mintynet/BSidesScotland2019/README.md

# BSidesScotland2019
Repository for information on the BSides Scotland 2019 / Car Hacking Village UK Badge
<br>The badge is a cheap device for people to get into car hacking, the sketch that will be below will cause disco mode on PD0 'The Car in a Box'
<br><br><b>BSides Scotland and I take no responsibility for any issues caused if using either the hardware or the code</b>
<br><br>Requires the use of the following Arduino library
<br><br>https://github.com/coryjfowler/MCP_CAN_lib
<br><br>Below is the components which are required to build your own BSides Scotland 2019 Badge
<br><br>The components shown below are available from aliexpress/ebay/amazon in that order of cost, but delivery time is probably highest on the cheaper.
<br><b>[Arduino Nano]</b>(https://www.ebay.co.uk/itm/USB-Nano-V3-0-ATMEGA328P-CH340G-5V-16M-Micro-Controller-Board-For-Arduino/201649419996)
<br><b>[MCP2515 Module]</b>(https://www.ebay.co.uk/itm/For-Arduino-MCP2515-CAN-Bus-Module-TJA1050-Receiver-SPI-Module/311520457612)
<br>I have used the above links from alice1101983 myself and delivery is normally 3 weeks to UK
<br><b>[OBD2 Plug]</b>(https://www.aliexpress.com/item/Car-Diagnostic-Tool-OBD-Male-Plug-16Pin-OBD2-Connector-OBD-2-16-Pin-OBD-II-Adaptor/32790225414.html)
<br>I have also used the above link, delivery has been varied from 9 to 40 days, but that may because I was ordering bulk.

<br><br>https://github.com/mintynet/nano-can has the other sketches for the device.

<br><b>Schematic</b>
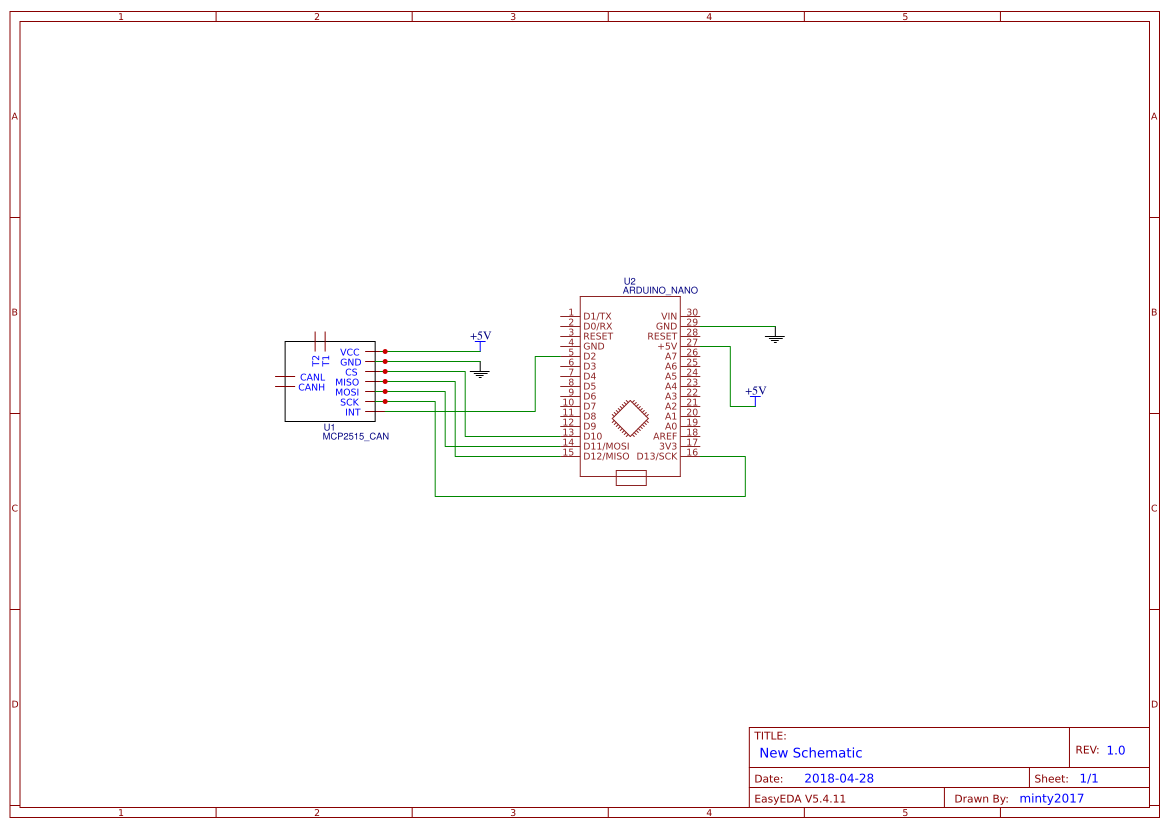
[picture p1: Schematic_nano-can-pcb.png]
PCB Schematic

Note:
<br><b>Arduino Nano</b>, the square at one end denote the position of the USB connector.
<br><b>TIP</b><br>Add extra solder to the sides of the USB connector or you may rip the USB connector of the board
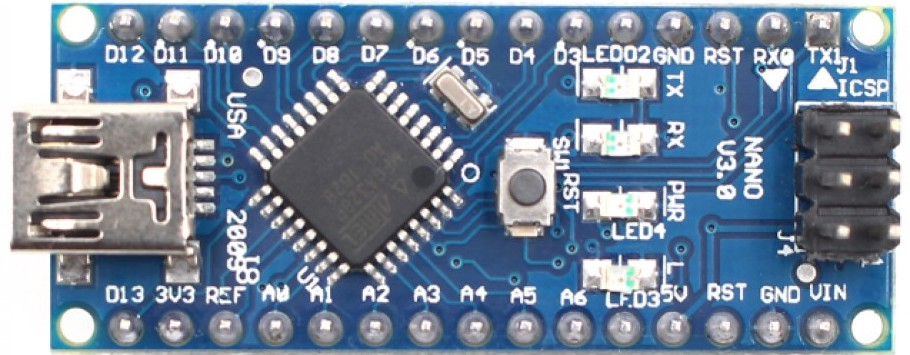
[picture p2: arduino-nano.jpg]
Arduino Nano

<br><b>MCP2515 Module</b> goes below the nano but <b>DO NOT</b> solder the Terminator Jumper or CAN pin headers to the PCB
<br>You may require a jumper on the Terminator resistor if using back to back.
<br>To solder the CAN module to the board, add extra solder to the back of the pins, then heat the pins and push through so that the pins are on the rear, then remove the plastic pin spacer left on the top and add extra solder to the pins.
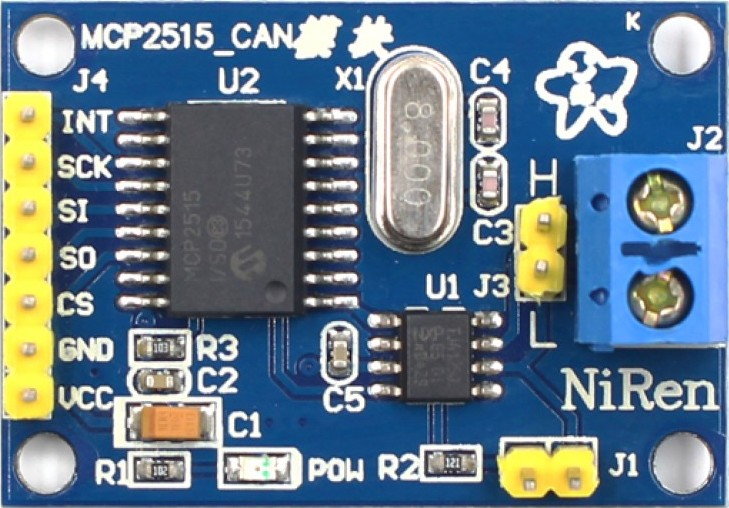
[picture p3: mcp2515.JPG]
MCP2515

<br>L goes to OBD2 pin 14
<br>H goes to OBD2 pin 6
<br><b>Completed Bottom</b>
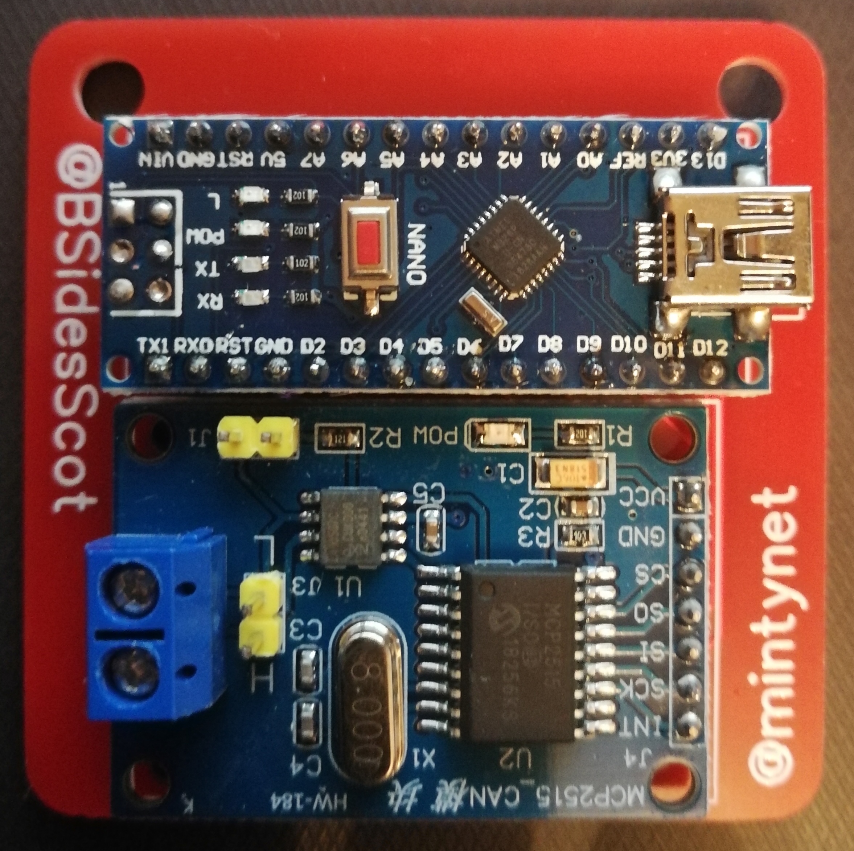
[picture p4: bottom-complete.jpg]
Completed BOTTOM

<br><b>OBD2 connector</b>
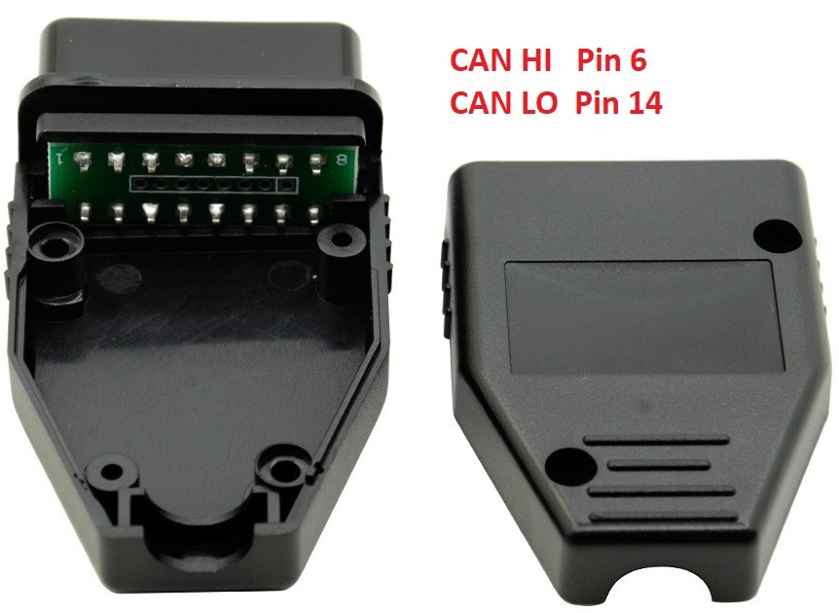
[picture p5: obd2-connector.jpg]
OBD2 connector

<br><b>PCB Top</b><br>
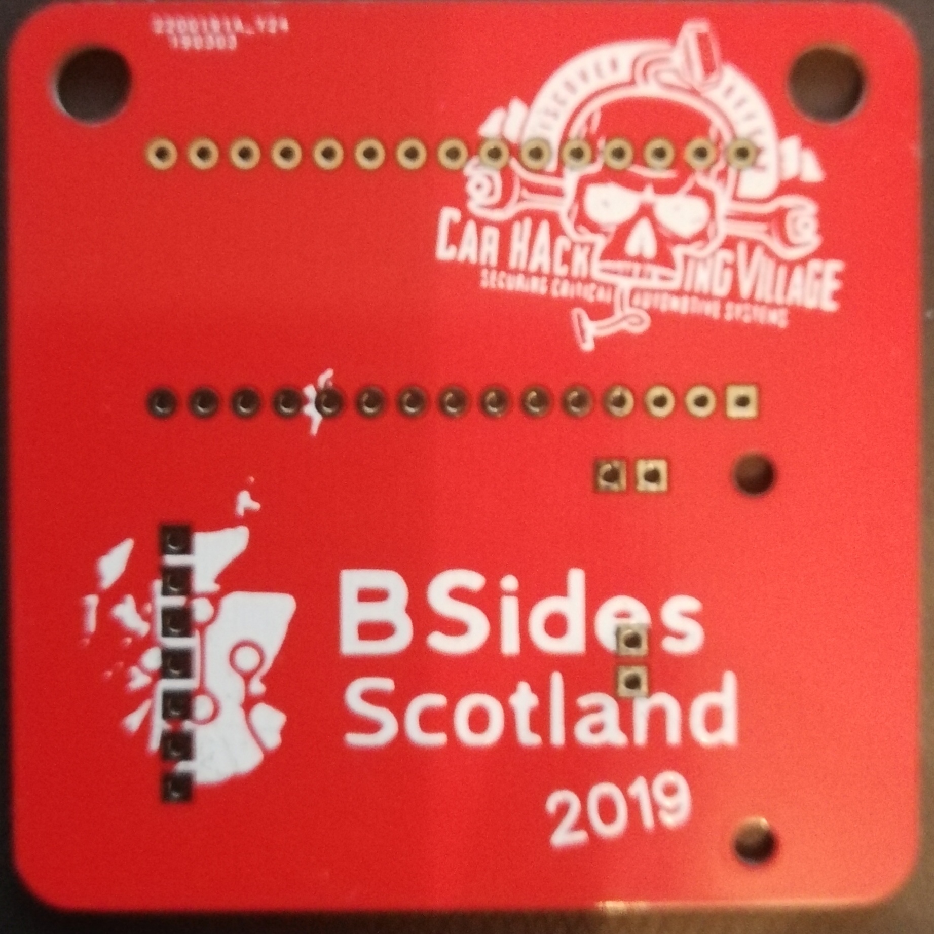
[picture p6: top-pcb.jpg]
PCB TOP

<br><b>PCB Bottom</b><br>
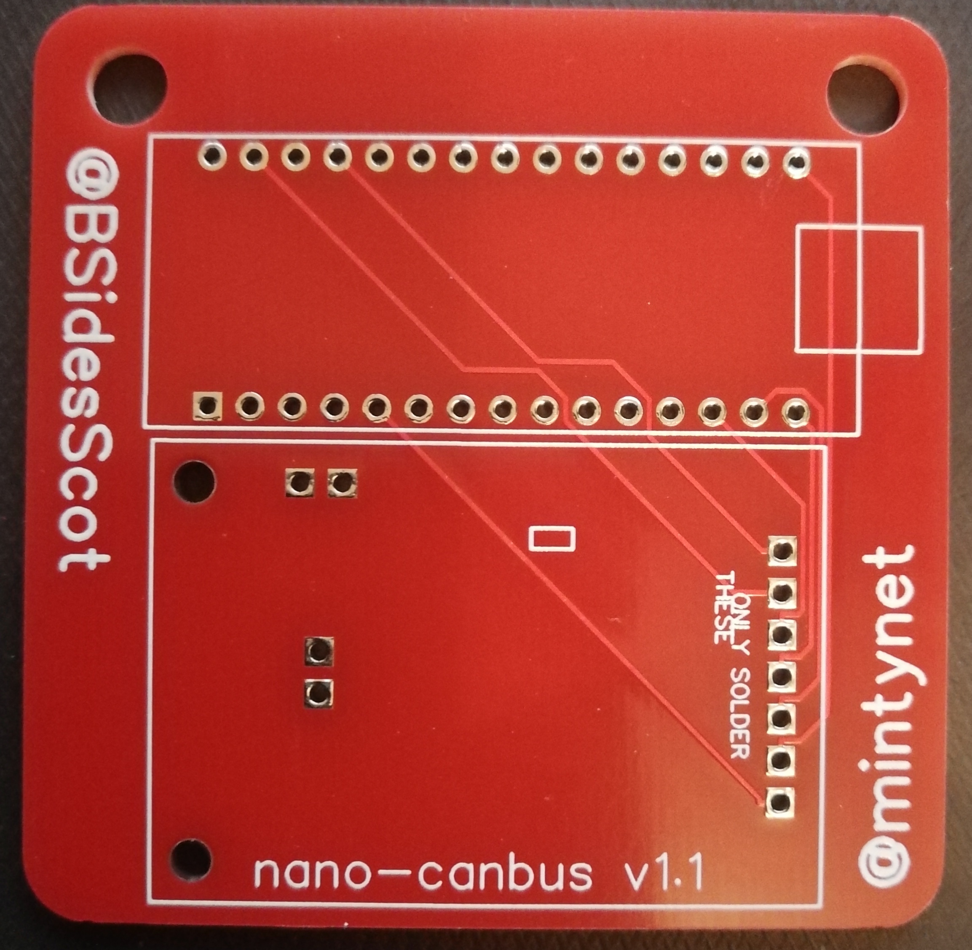
[picture p7: bottom-pcb.jpg]
PCB BOTTOM
