mintynet/BSidesScotland2019/build.md

# Build instructions
## Tools required
<br>Soldering Iron
<br>Solder
<br>Side cutters
<br>Wire strippers
<br>Small screw driver
## Software requirements.
<br>Arduino IDE
<br>Requires the use of the following Arduino library
<br><br>https://github.com/coryjfowler/MCP_CAN_lib
<br>If you have the ability to, burn the new Arduino nano bootloader to the board.
<br><br>Then program with can-receive-all sketch

## Instructions
<br>Parts plus 2 core wire is required (PCB will be the BSides Scotland Badge)
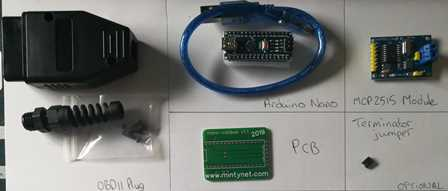
[picture p8: build/build01.jpg]
Parts plus 2 core wire is required (PCB will be the BSides Scotland Badge)
<br>
<br>PCB in holder
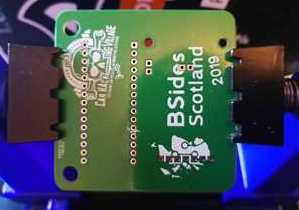
[picture p9: build/build02.jpg]
PCB in holder
<br>
<br>PCB rear in holder
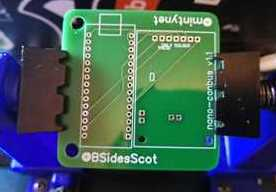
[picture p10: build/build02a.jpg]
PCB rear in holder
<br>
<br>Board with Arduino nano
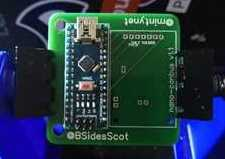
[picture p11: build/build03.jpg]
Board with Arduino nano
<br>
<br>Board with Arduino nano with additional solder on USB plug
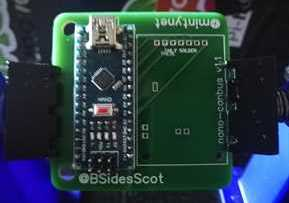
[picture p12: build/build04.jpg]
Board with Arduino nano with additional solder on USB plug
<br>
<br>Board with Arduino nano soldered in opposite corners
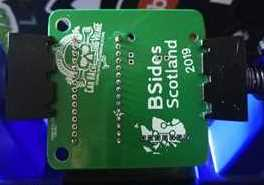
[picture p13: build/build05.jpg]
Board with Arduino nano soldered in opposite corners
<br>
<br>Board with Arduino nano fully soldered
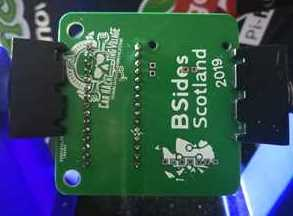
[picture p14: build/build06.jpg]
Board with Arduino nano fully soldered
<br>
<br>Board with Arduino nano pins cut short
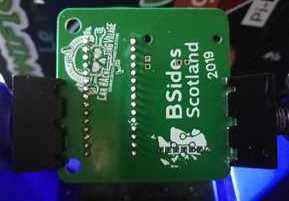
[picture p15: build/build07.jpg]
Board with Arduino nano pins cut short
<br>
<br>MCP2515 Module rear
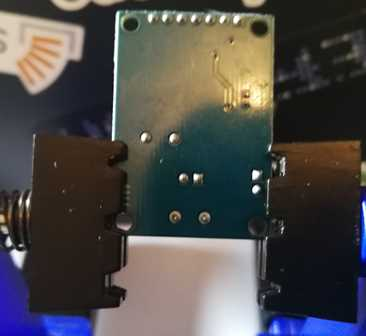
[picture p16: build/build09.jpg]
MCP2515 Module rear
<br>
<br>MCP2515 some pins pushed through
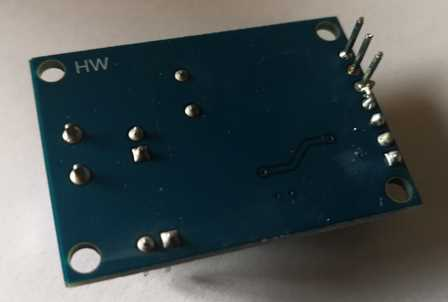
[picture p17: build/build10.jpg]
MCP2515 some pins pushed through
<br>
<br>MCP2515 all pins pushed through
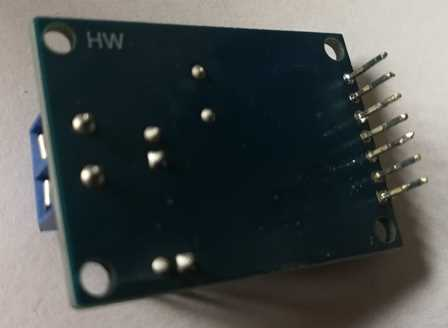
[picture p18: build/build11.jpg]
MCP2515 all pins pushed through
<br>
<br>MCP2515 module in place
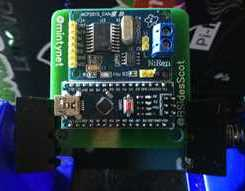
[picture p19: build/build12.jpg]
MCP2515 module in place
<br>
<br>MCP2515 module without pin header plastic
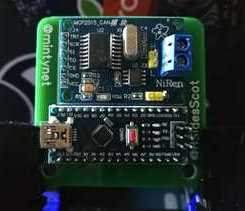
[picture p20: build/build15.jpg]
MCP2515 module without pin header plastic
<br>
<br>MCP2515 module rear soldered and terminator jumper
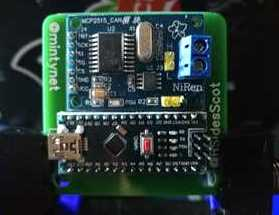
[picture p21: build/build16.jpg]
MCP2515 module rear soldered and terminator jumper
<br>
<br>OBD2 plug
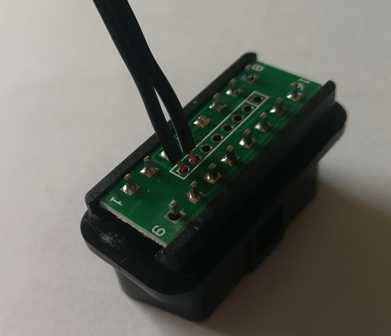
[picture p22: build/build19.jpg]
OBD2 plug
<br>
<br>OBD2 cable and drill
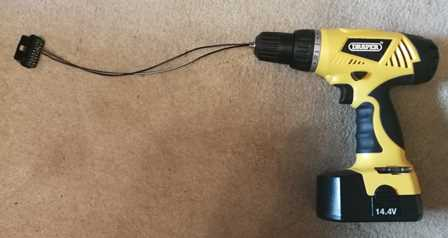
[picture p23: build/build20.jpg]
OBD2 cable and drill
<br>
<br>OBD2 cable twisted pair
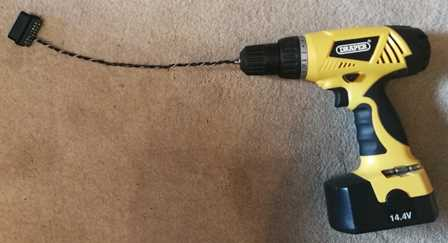
[picture p24: build/build21.jpg]
OBD2 cable twisted pair
<br>
<br>Complete Front
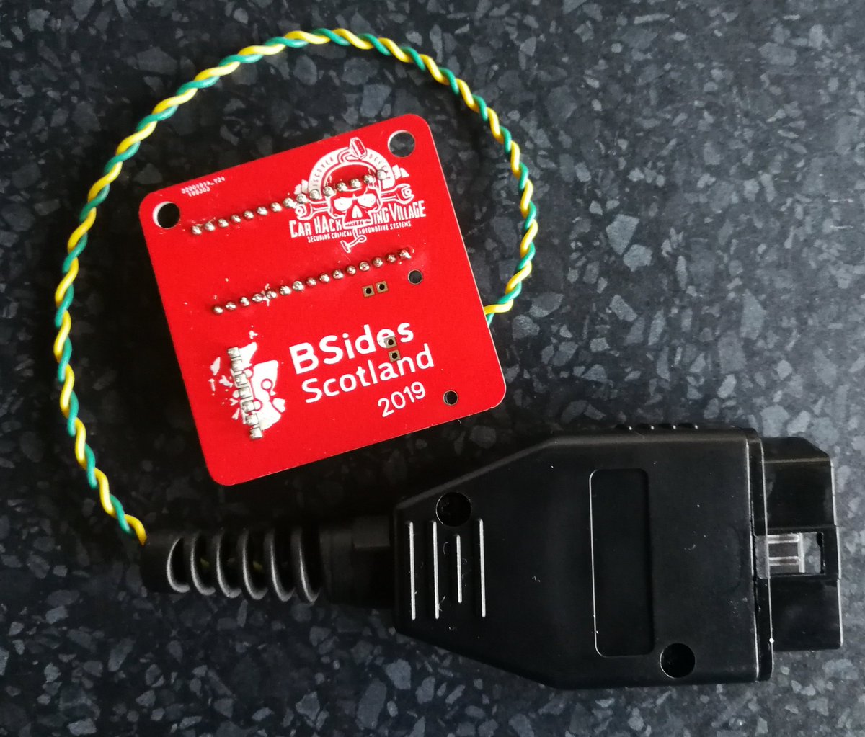
[picture p25: build/build22.jpg]
Complete Top
<br>
<br>Complete Rear
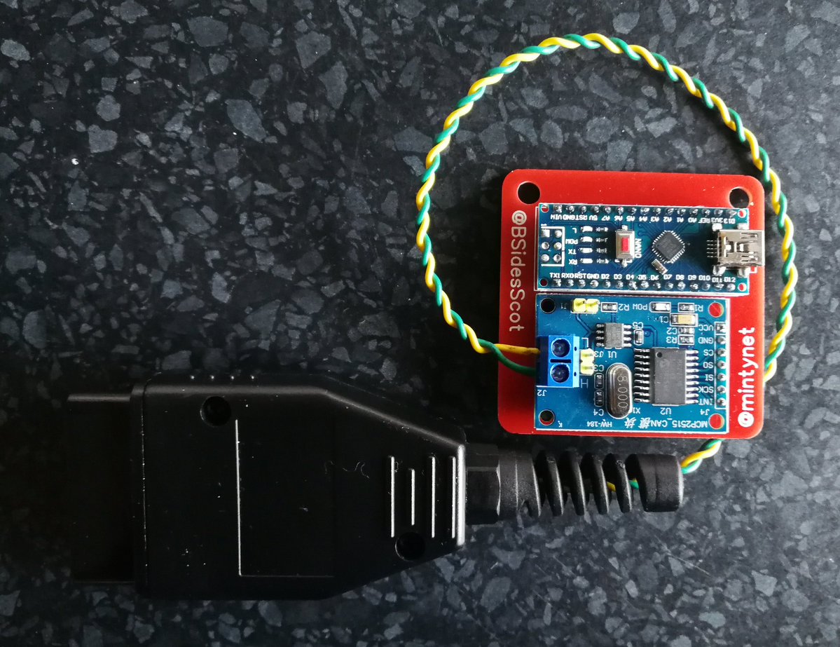
[picture p26: build/build23.jpg]
Complete Rear
<br>
